ashleyjr/tt04-delay-line/src/notes/20230805/note.md

# Delay

- Time to delay across 10Qty sky130_fd_sc_hd__inv_1
- Prcoess, Voltage, Temprature

| Corner | Temp (C) | Voltage (V) | Delay (ns)  |
| --- | --- | --- | --- |
| ss | 0 | 1.2 | 1.75 |
| ss | 0 | 1.4 | 0.77 |
| ss | 0 | 1.6 | 0.49 |
| ss | 0 | 1.8 | 0.37 |
| ss | 0 | 2.0 | 0.29 |
| ss | 27 | 1.2 | 1.46 |
| ss | 27 | 1.4 | 0.73 |
| ss | 27 | 1.6 | 0.48 |
| ss | 27 | 1.8 | 0.37 |
| ss | 27 | 2.0 | 0.30 |
| ss | 80 | 1.2 | 1.13 |
| ss | 80 | 1.4 | 0.65 |
| ss | 80 | 1.6 | 0.47 |
| ss | 80 | 1.8 | 0.37 |
| ss | 80 | 2.0 | 0.31 |
| tt | 0 | 1.2 | 0.85 |
| tt | 0 | 1.4 | 0.45 |
| tt | 0 | 1.6 | 0.32 |
| tt | 0 | 1.8 | 0.25 |
| tt | 0 | 2.0 | 0.21 |
| tt | 27 | 1.2 | 0.74 |
| tt | 27 | 1.4 | 0.43 |
| tt | 27 | 1.6 | 0.31 |
| tt | 27 | 1.8 | 0.24 |
| tt | 27 | 2.0 | 0.22 |
| tt | 80 | 1.2 | 0.62 |
| tt | 80 | 1.4 | 0.40 |
| tt | 80 | 1.6 | 0.31 |
| tt | 80 | 1.8 | 0.26 |
| tt | 80 | 2.0 | 0.22 |
| ff | 0 | 1.2 | 0.47 |
| ff | 0 | 1.4 | 0.29 |
| ff | 0 | 1.6 | 0.22 |
| ff | 0 | 1.8 | 0.18 |
| ff | 0 | 2.0 | 0.16 |
| ff | 27 | 1.2 | 0.42 |
| ff | 27 | 1.4 | 0.28 |
| ff | 27 | 1.6 | 0.21 |
| ff | 27 | 1.8 | 0.18 |
| ff | 27 | 2.0 | 0.16 |
| ff | 80 | 1.2 | 0.37 |
| ff | 80 | 1.4 | 0.26 |
| ff | 80 | 1.6 | 0.21 |
| ff | 80 | 1.8 | 0.18 |
| ff | 80 | 2.0 | 0.16 |

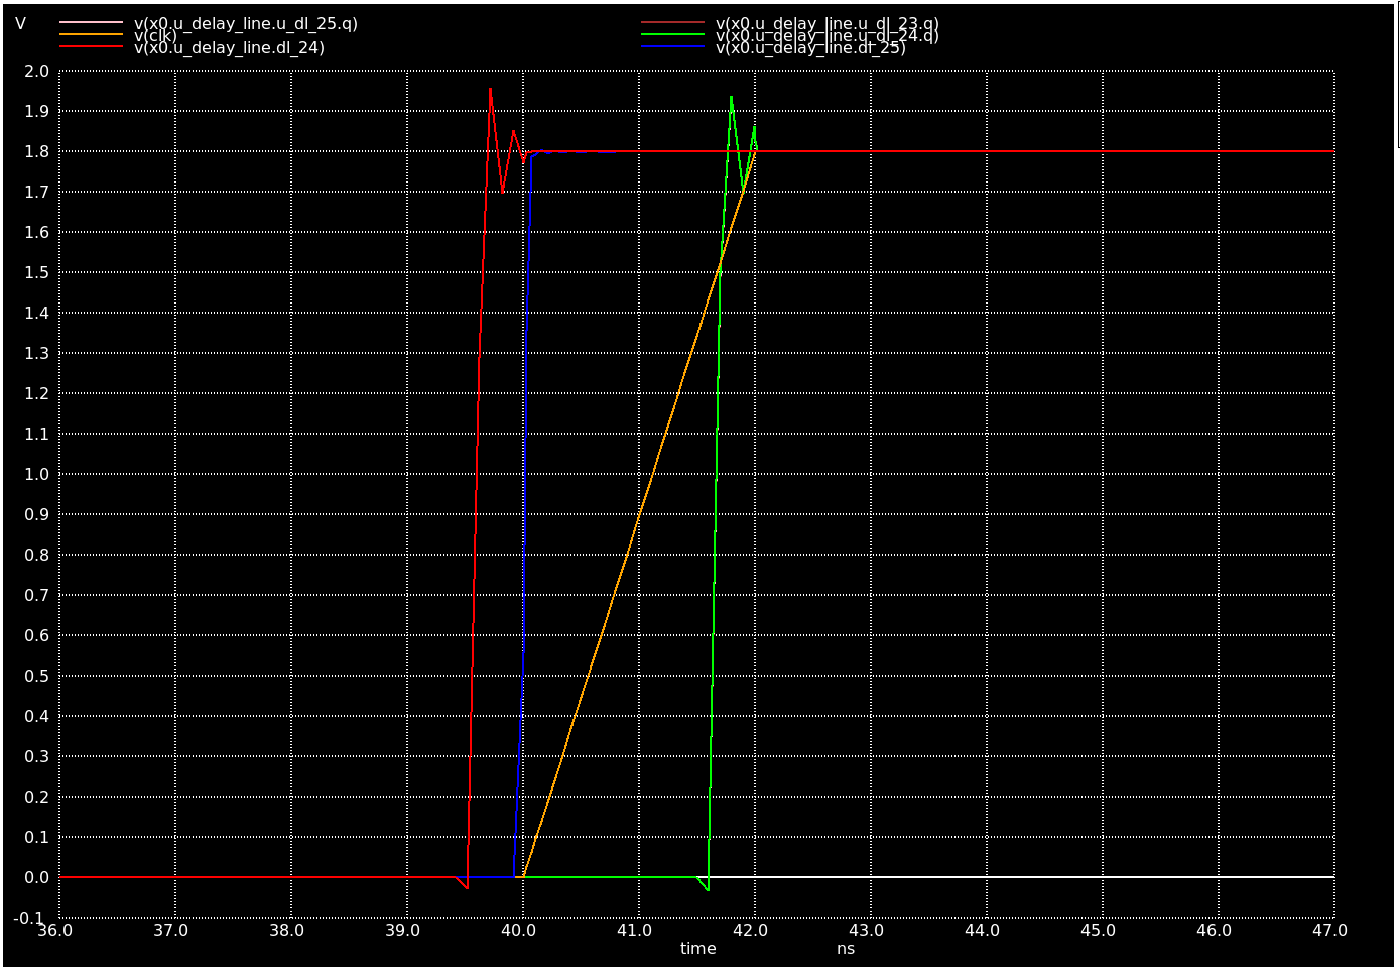
[picture p5: src/notes/20230804/capture.png]
