ashleyjr/tt04-delay-line/src/notes/20230804/note.md

# Delay

- First capture on the delay as position 24 
