ashleyjr/tt04-delay-line/src/notes/20230731/notes.md

# Delay

- Seeing ~2ns to cross the entire delay lines, too short...

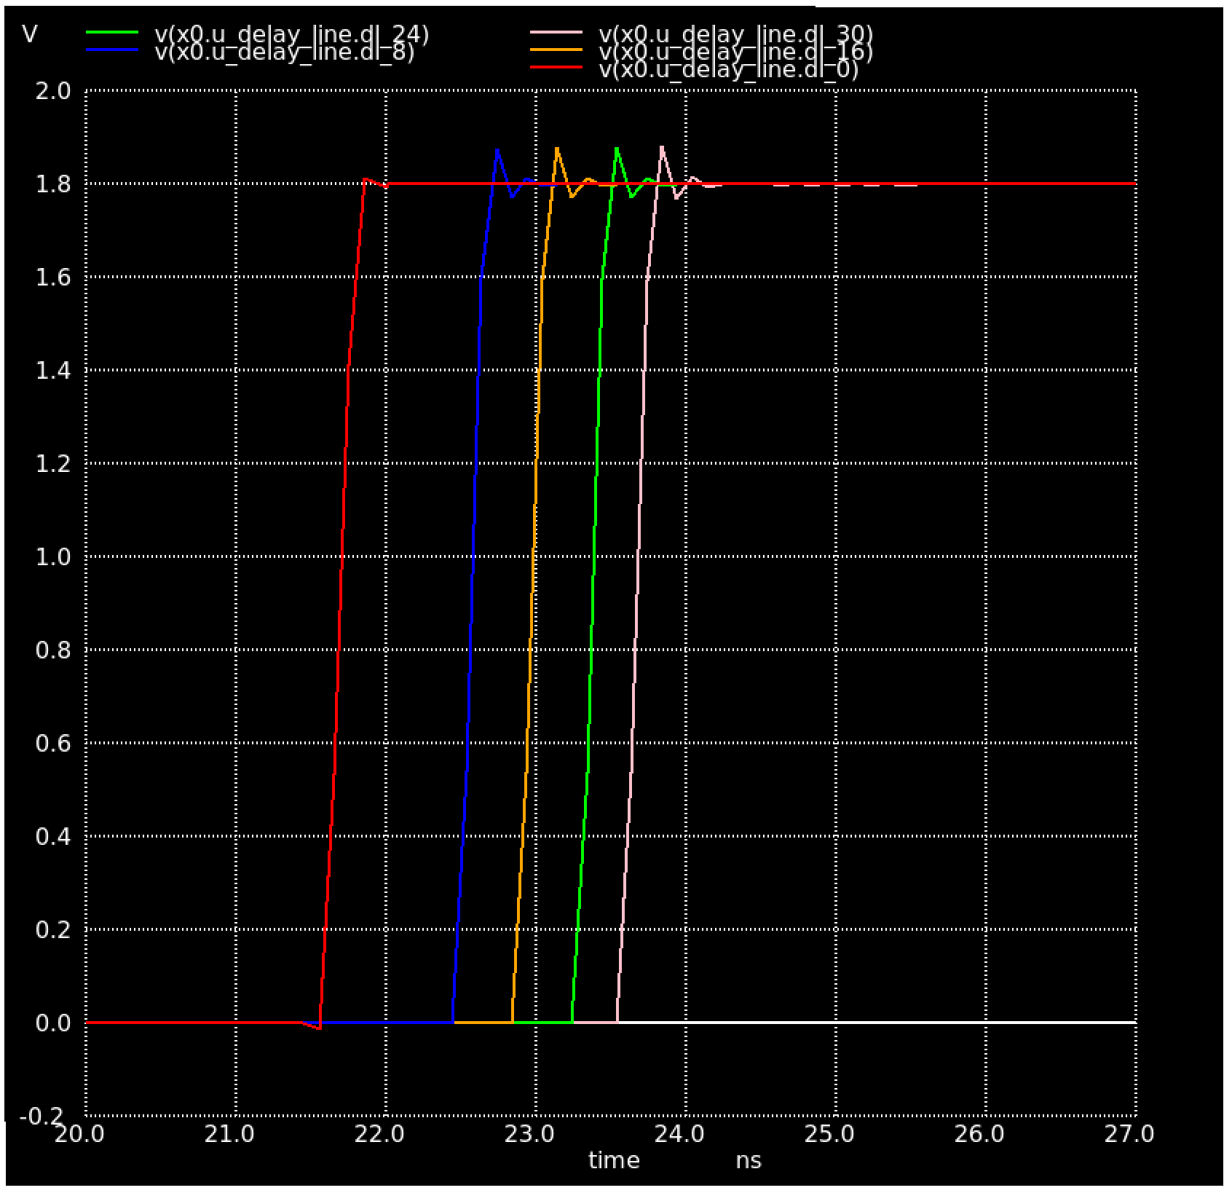
[picture p11: src/notes/20230731/rise.png]


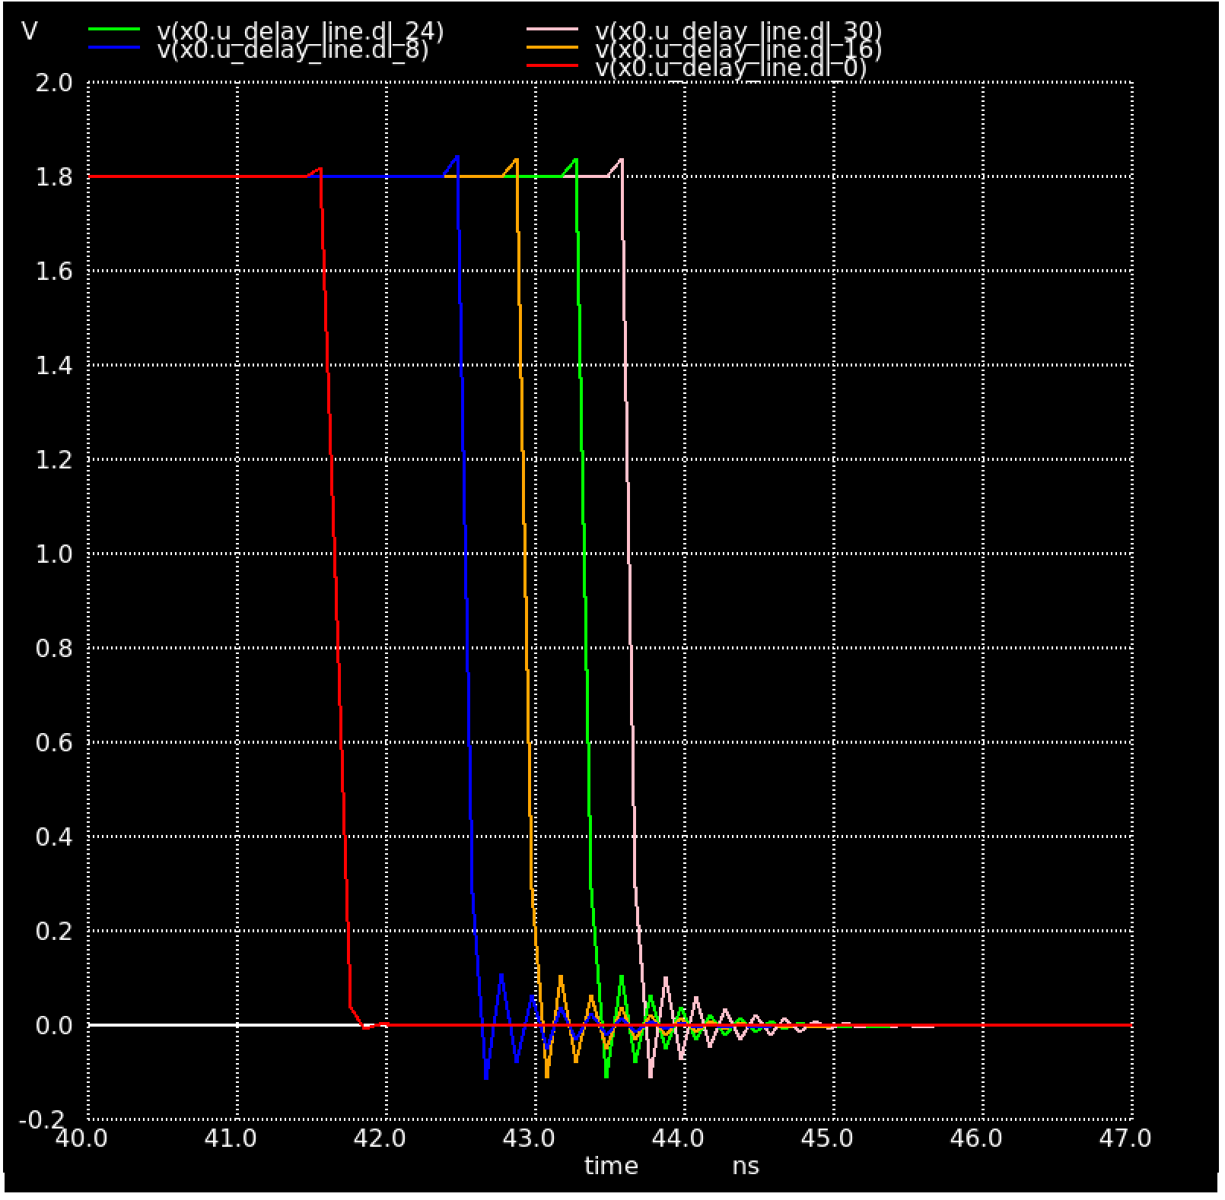
[picture p12: src/notes/20230731/fall.png]


- With the parasitic extraction this increases to ~3.5ns 

- The simulation take x10 longer to run with parasitics extraction

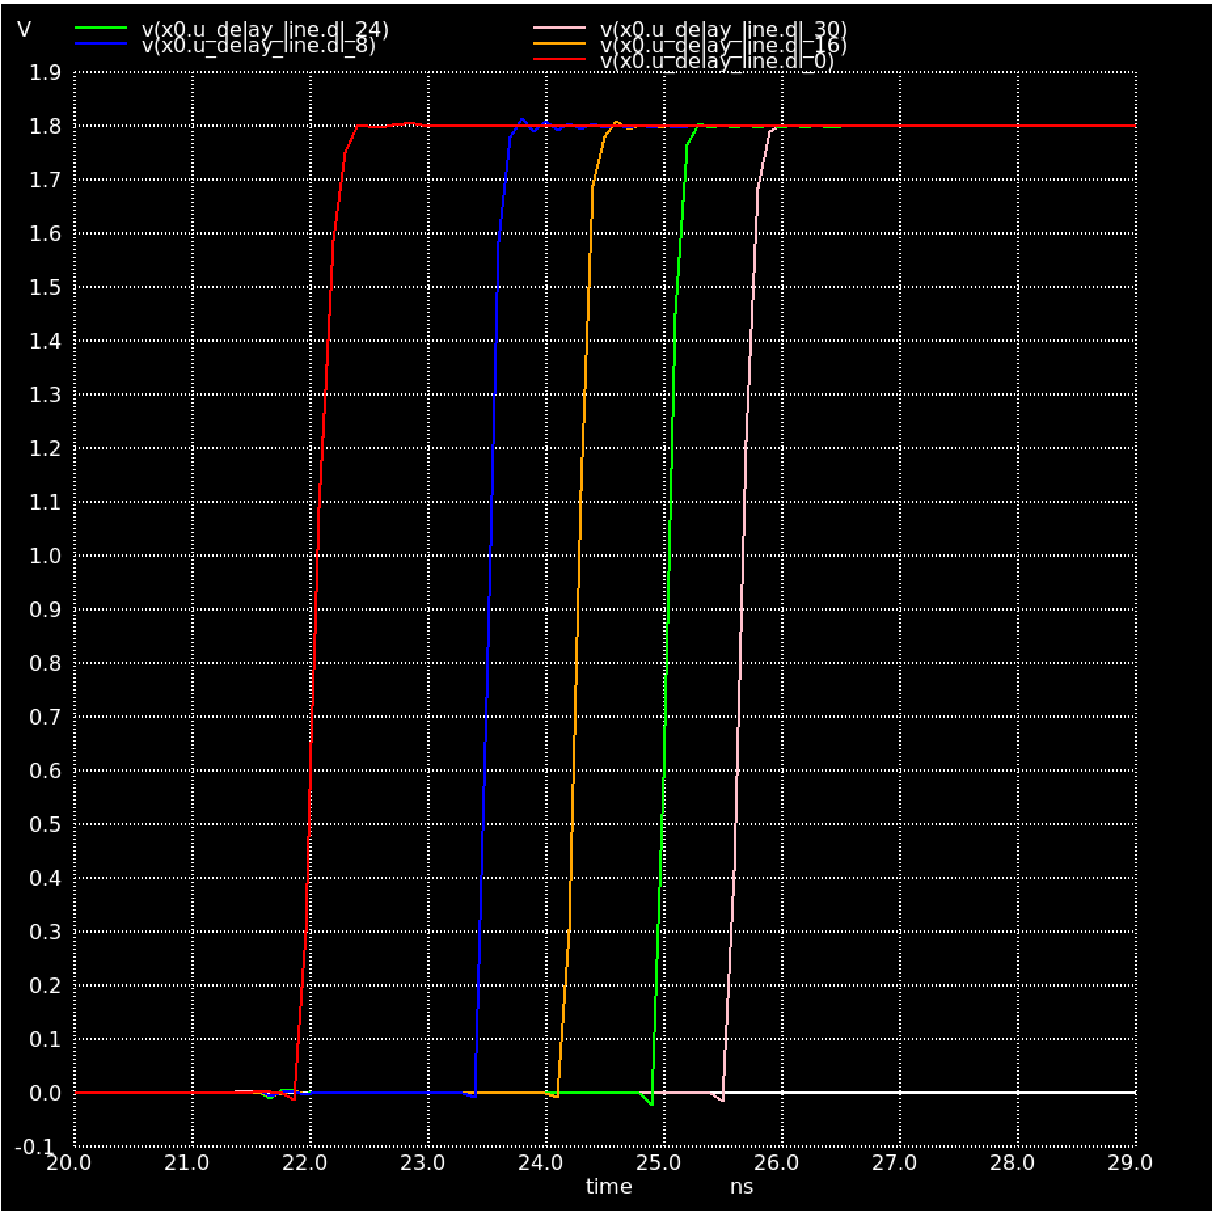
[picture p13: src/notes/20230731/parasitics_rise.png]


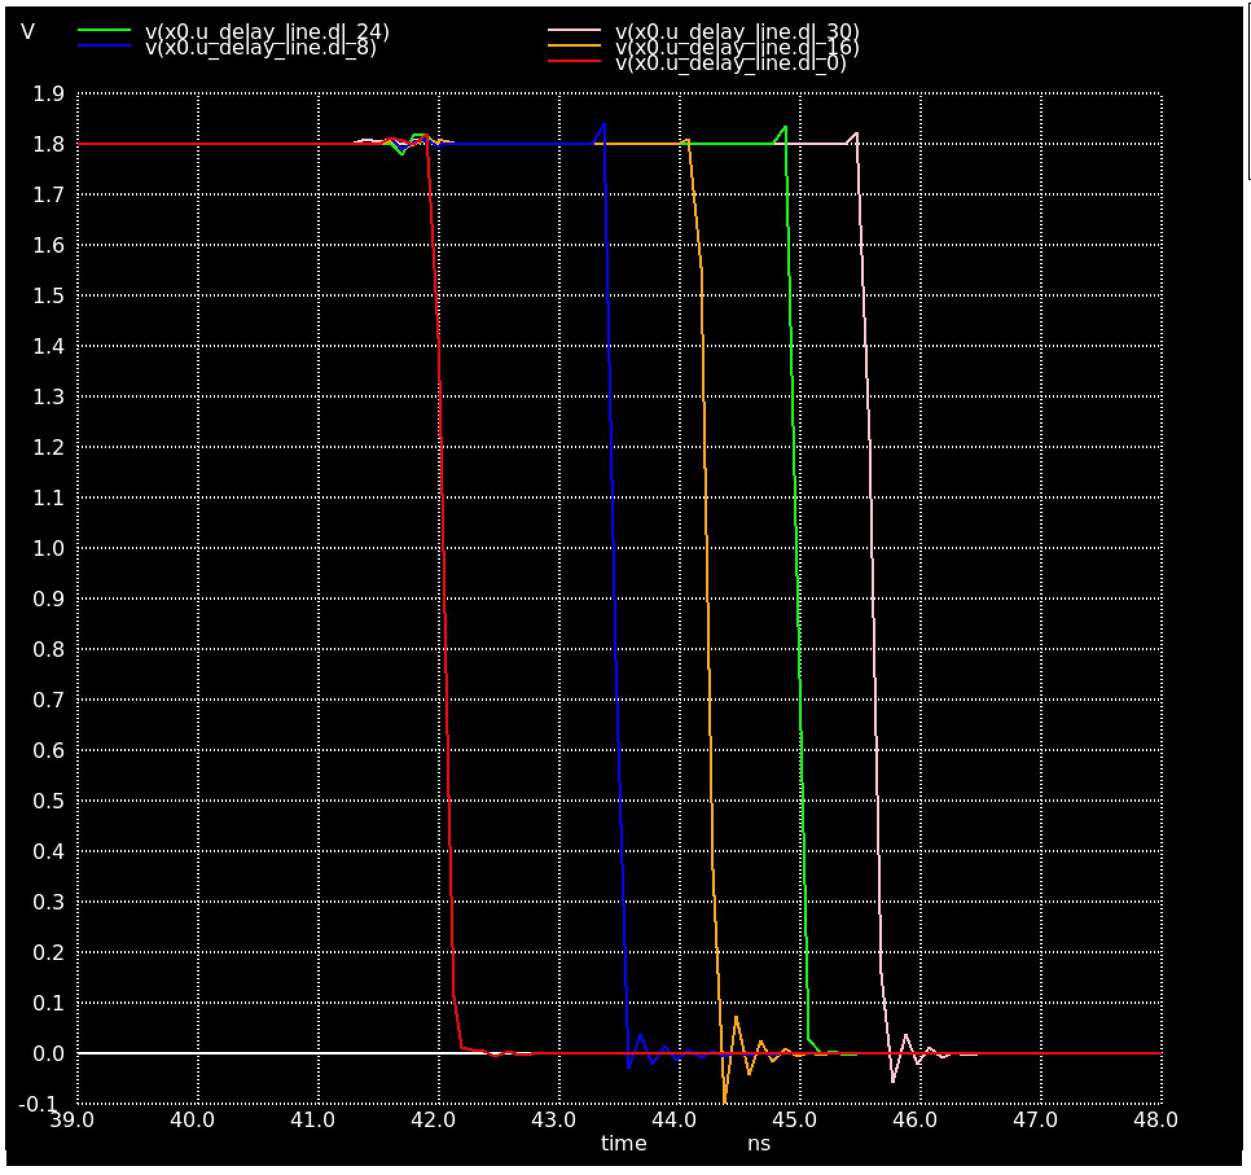
[picture p14: src/notes/20230731/parasitics_fall.png]


- Increasing the number of inverters to 8 per stage still does 
  reach the rising edge of the next clock

- The names for the resync also gets squashed so might need more
  keep = true

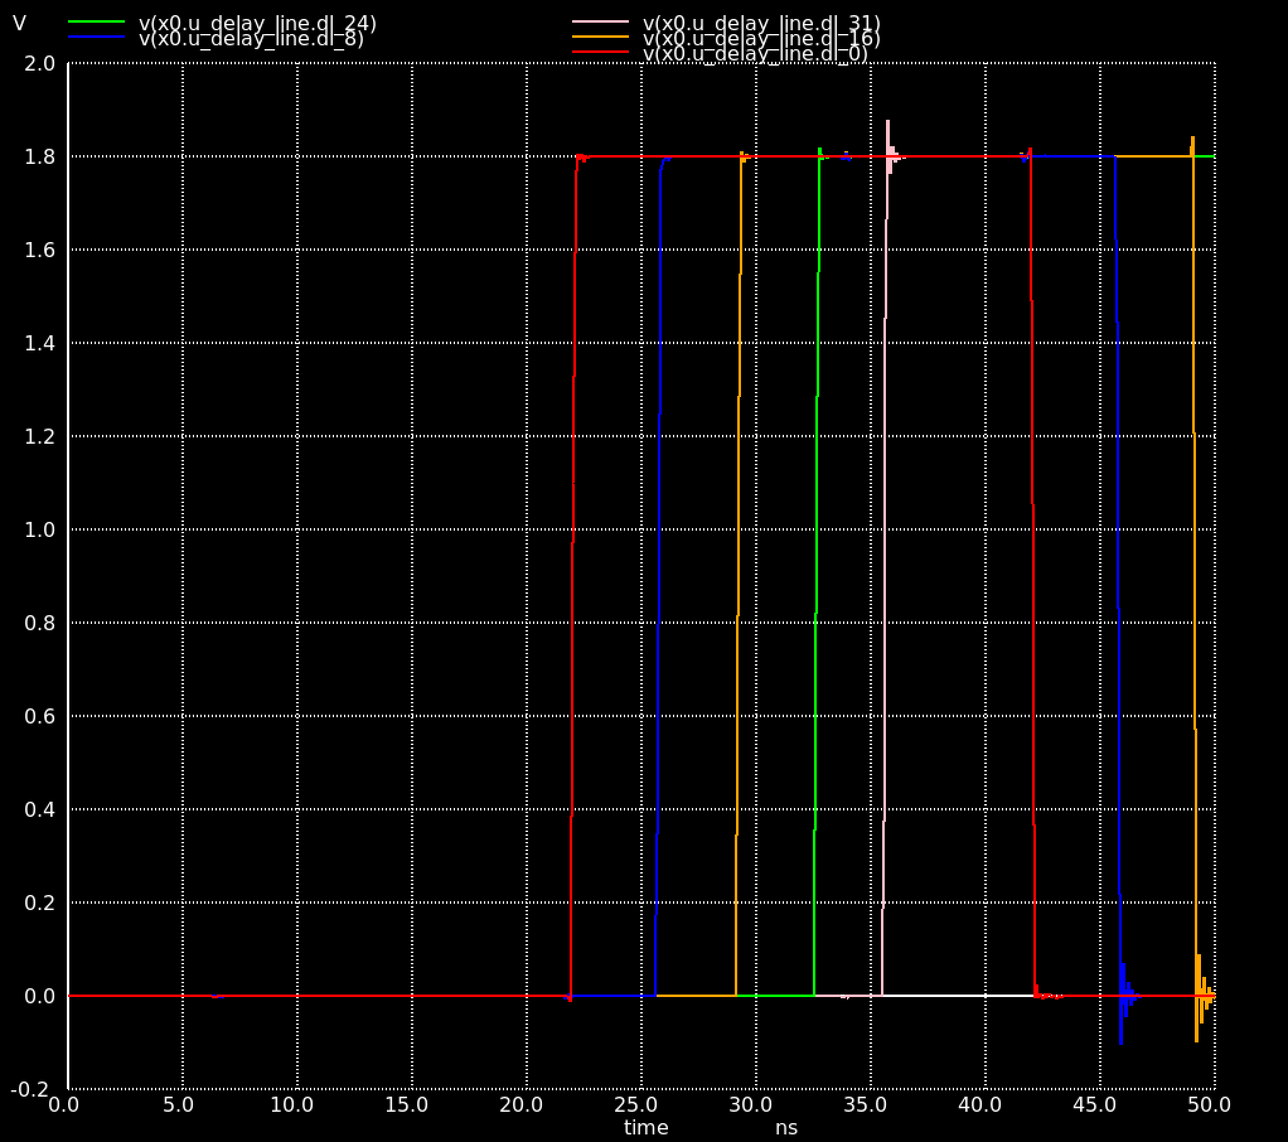
[picture p15: src/notes/20230731/8_inv_per_stage.png]
