ashleyjr/tt04-delay-line/(threads)

Thread 3 (2023-08-03):

Correct polarity reset

ashleyjr, 2023-08-03:
Lots of flipping back and forth for reset polarity.

Party to re-use UART RTL but in the delay the flops are the wrong polarity so resets are unflipped.

Best to keep one reset throughout

ashleyjr, 2023-08-16:
Made all ffs the same no need to invert reset

Closed 2023-08-16.
