ashleyjr/tt04-delay-line/(commit log)

2023-07-14 add uarts
2023-07-16 add driver
2023-08-15 reduce to 10 samples
2023-08-15 8 samples
2023-08-21 voltage sweep first
2023-08-21 reduce number of stages
